mertwole/tetris/fpga_to_pcie/schematic.pdf

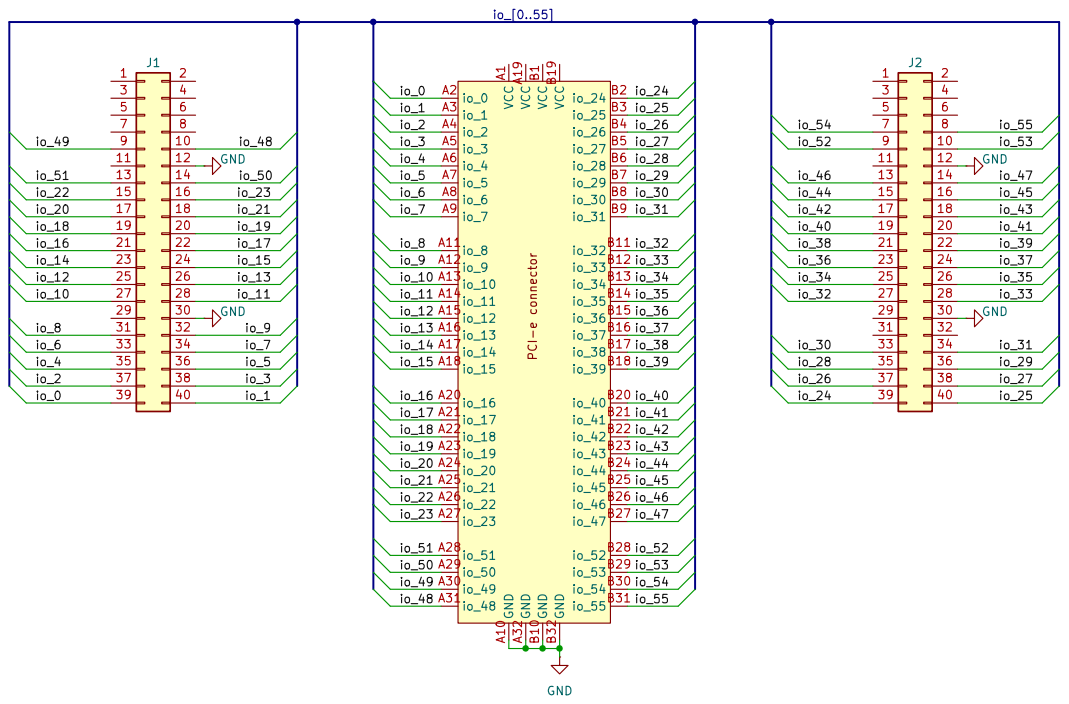
[picture p1: page 1]
