mertwole/tetris/module_tester/schematic.pdf

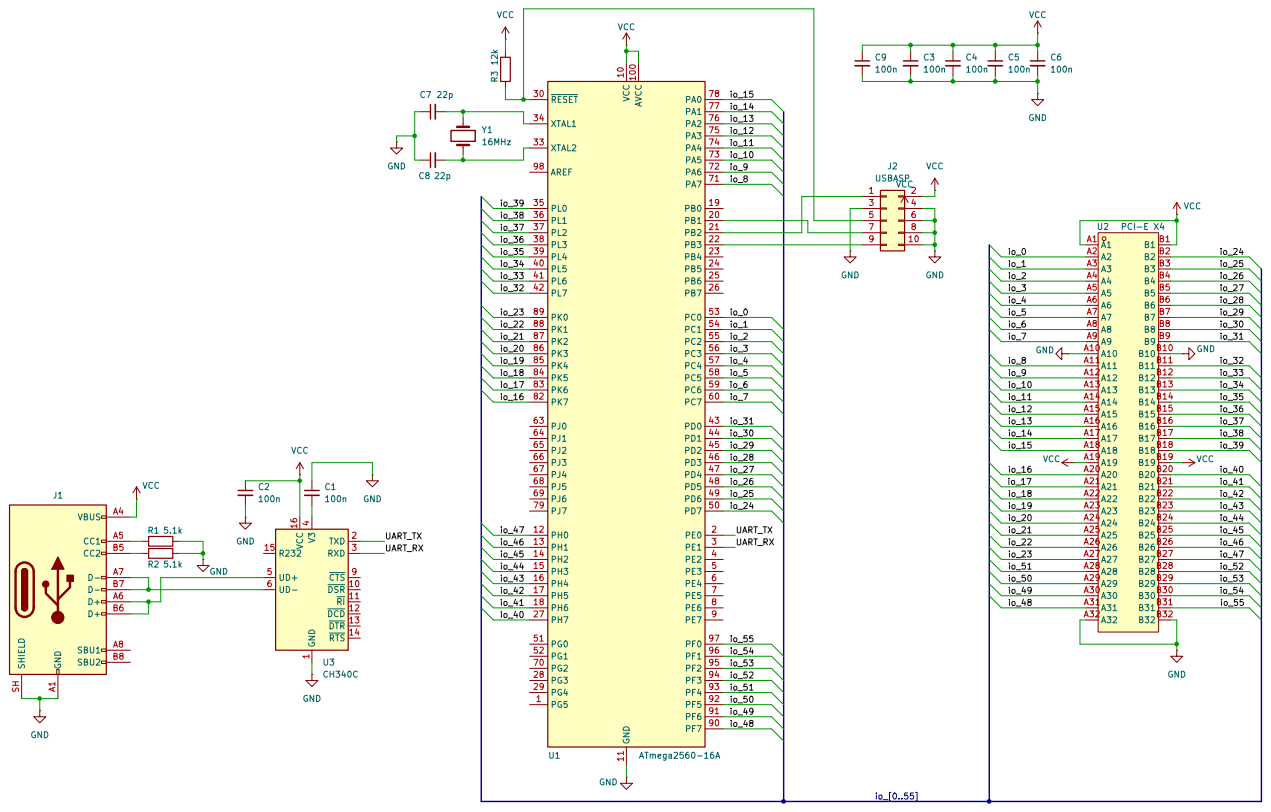
[picture p2: page 1]
