mertwole/tetris/fpga_to_pcie/fpga_to_pcie.kicad_pcb

## KiCad design fpga_to_pcie/fpga_to_pcie.kicad_pcb (2026-09-05)

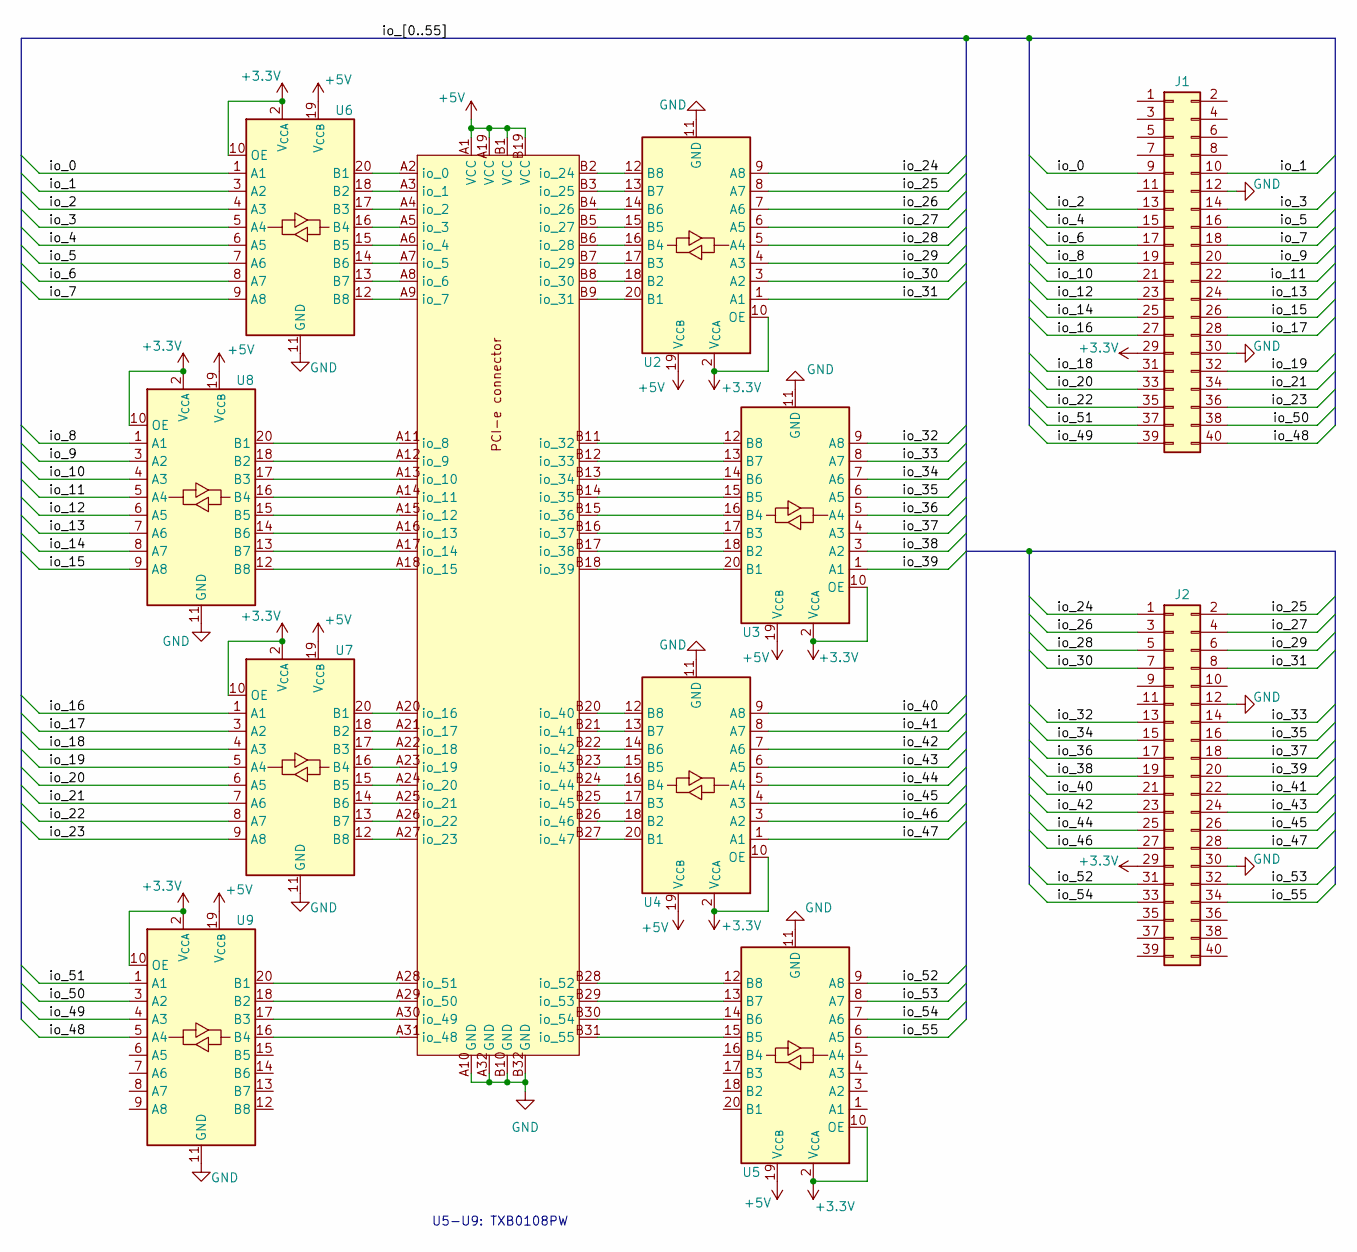
[picture p3: schematic fpga_to_pcie.kicad_sch]

Parts:
J1, J2: Conn_02x20_Odd_Even; IDC-Header_2x20_P2.54mm_Vertical
U1: BUS_PCIexpress_x4
U2, U3, U4, U5, U6, U7, U8, U9: TXB0108PW; TSSOP-20_4.4x6.5mm_P0.65mm

Connections:
+3.3V: J1.29, J2.29, U2.2 (V_{CCA}), U2.10 (OE), U3.2 (V_{CCA}), U3.10 (OE), U4.2 (V_{CCA}), U4.10 (OE), U5.2 (V_{CCA}), U5.10 (OE), U6.2 (V_{CCA}), U6.10 (OE), U7.2 (V_{CCA}), U7.10 (OE), U8.2 (V_{CCA}), U8.10 (OE), U9.2 (V_{CCA}), U9.10 (OE)
+5V: U1.A1 (VCC), U1.A19 (VCC), U1.B1 (VCC), U1.B19 (VCC), U2.19 (V_{CCB}), U3.19 (V_{CCB}), U4.19 (V_{CCB}), U5.19 (V_{CCB}), U6.19 (V_{CCB}), U7.19 (V_{CCB}), U8.19 (V_{CCB}), U9.19 (V_{CCB})
/io_0: J1.9, U6.1 (A1)
/io_1: J1.10, U6.3 (A2)
/io_2: J1.13, U6.4 (A3)
/io_3: J1.14, U6.5 (A4)
/io_4: J1.15, U6.6 (A5)
/io_5: J1.16, U6.7 (A6)
/io_6: J1.17, U6.8 (A7)
/io_7: J1.18, U6.9 (A8)
/io_8: J1.19, U8.1 (A1)
/io_9: J1.20, U8.3 (A2)
/io_10: J1.21, U8.4 (A3)
/io_11: J1.22, U8.5 (A4)
/io_12: J1.23, U8.6 (A5)
/io_13: J1.24, U8.7 (A6)
/io_14: J1.25, U8.8 (A7)
/io_15: J1.26, U8.9 (A8)
/io_16: J1.27, U7.1 (A1)
/io_17: J1.28, U7.3 (A2)
/io_18: J1.31, U7.4 (A3)
/io_19: J1.32, U7.5 (A4)
/io_20: J1.33, U7.6 (A5)
/io_21: J1.34, U7.7 (A6)
/io_22: J1.35, U7.8 (A7)
/io_23: J1.36, U7.9 (A8)
/io_24: J2.1, U2.9 (A8)
/io_25: J2.2, U2.8 (A7)
/io_26: J2.3, U2.7 (A6)
/io_27: J2.4, U2.6 (A5)
/io_28: J2.5, U2.5 (A4)
/io_29: J2.6, U2.4 (A3)
/io_30: J2.7, U2.3 (A2)
/io_31: J2.8, U2.1 (A1)
/io_32: J2.13, U3.9 (A8)
/io_33: J2.14, U3.8 (A7)
/io_34: J2.15, U3.7 (A6)
/io_35: J2.16, U3.6 (A5)
/io_36: J2.17, U3.5 (A4)
/io_37: J2.18, U3.4 (A3)
/io_38: J2.19, U3.3 (A2)
/io_39: J2.20, U3.1 (A1)
/io_40: J2.21, U4.9 (A8)
/io_41: J2.22, U4.8 (A7)
/io_42: J2.23, U4.7 (A6)
/io_43: J2.24, U4.6 (A5)
/io_44: J2.25, U4.5 (A4)
/io_45: J2.26, U4.4 (A3)
/io_46: J2.27, U4.3 (A2)
/io_47: J2.28, U4.1 (A1)
/io_48: J1.40, U9.5 (A4)
/io_49: J1.39, U9.4 (A3)
/io_50: J1.38, U9.3 (A2)
/io_51: J1.37, U9.1 (A1)
/io_52: J2.31, U5.9 (A8)
/io_53: J2.32, U5.8 (A7)
/io_54: J2.33, U5.7 (A6)
/io_55: J2.34, U5.6 (A5)
GND: J1.12, J1.30, J2.12, J2.30, U1.A10 (GND), U1.A32 (GND), U1.B10 (GND), U1.B32 (GND), U2.11 (GND), U3.11 (GND), U4.11 (GND), U5.11 (GND), U6.11 (GND), U7.11 (GND), U8.11 (GND), U9.11 (GND)
unnamed: U1.A2 (io_0), U6.20 (B1)
unnamed: U1.A3 (io_1), U6.18 (B2)
unnamed: U1.A4 (io_2), U6.17 (B3)
unnamed: U1.A5 (io_3), U6.16 (B4)
unnamed: U1.A6 (io_4), U6.15 (B5)
unnamed: U1.A7 (io_5), U6.14 (B6)
unnamed: U1.A8 (io_6), U6.13 (B7)
unnamed: U1.A9 (io_7), U6.12 (B8)
unnamed: U1.A11 (io_8), U8.20 (B1)
unnamed: U1.A12 (io_9), U8.18 (B2)
unnamed: U1.A13 (io_10), U8.17 (B3)
unnamed: U1.A14 (io_11), U8.16 (B4)
unnamed: U1.A15 (io_12), U8.15 (B5)
unnamed: U1.A16 (io_13), U8.14 (B6)
unnamed: U1.A17 (io_14), U8.13 (B7)
unnamed: U1.A18 (io_15), U8.12 (B8)
unnamed: U1.A20 (io_16), U7.20 (B1)
unnamed: U1.A21 (io_17), U7.18 (B2)
unnamed: U1.A22 (io_18), U7.17 (B3)
unnamed: U1.A23 (io_19), U7.16 (B4)
unnamed: U1.A24 (io_20), U7.15 (B5)
unnamed: U1.A25 (io_21), U7.14 (B6)
unnamed: U1.A26 (io_22), U7.13 (B7)
unnamed: U1.A27 (io_23), U7.12 (B8)
unnamed: U1.B2 (io_24), U2.12 (B8)
unnamed: U1.B3 (io_25), U2.13 (B7)
unnamed: U1.B4 (io_26), U2.14 (B6)
unnamed: U1.B5 (io_27), U2.15 (B5)
unnamed: U1.B6 (io_28), U2.16 (B4)
unnamed: U1.B7 (io_29), U2.17 (B3)
unnamed: U1.B8 (io_30), U2.18 (B2)
unnamed: U1.B9 (io_31), U2.20 (B1)
unnamed: U1.B11 (io_32), U3.12 (B8)
unnamed: U1.B12 (io_33), U3.13 (B7)
unnamed: U1.B13 (io_34), U3.14 (B6)
unnamed: U1.B14 (io_35), U3.15 (B5)
unnamed: U1.B15 (io_36), U3.16 (B4)
unnamed: U1.B16 (io_37), U3.17 (B3)
unnamed: U1.B17 (io_38), U3.18 (B2)
unnamed: U1.B18 (io_39), U3.20 (B1)
unnamed: U1.B20 (io_40), U4.12 (B8)
unnamed: U1.B21 (io_41), U4.13 (B7)
unnamed: U1.B22 (io_42), U4.14 (B6)
unnamed: U1.B23 (io_43), U4.15 (B5)
unnamed: U1.B24 (io_44), U4.16 (B4)
unnamed: U1.B25 (io_45), U4.17 (B3)
unnamed: U1.B26 (io_46), U4.18 (B2)
unnamed: U1.B27 (io_47), U4.20 (B1)
unnamed: U1.A31 (io_48), U9.16 (B4)
unnamed: U1.A30 (io_49), U9.17 (B3)
unnamed: U1.A29 (io_50), U9.18 (B2)
unnamed: U1.A28 (io_51), U9.20 (B1)
unnamed: U1.B28 (io_52), U5.12 (B8)
unnamed: U1.B29 (io_53), U5.13 (B7)
unnamed: U1.B30 (io_54), U5.14 (B6)
unnamed: U1.B31 (io_55), U5.15 (B5)

Notes on the sheet:
U5-U9: TXB0108PW

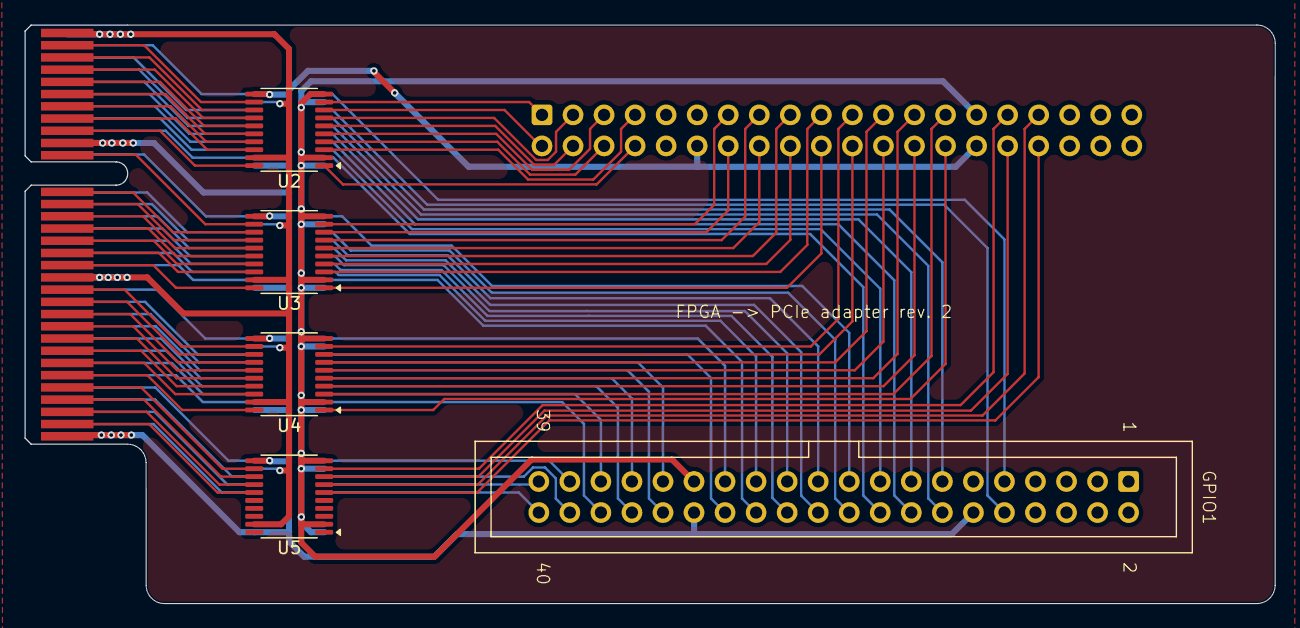
[picture p4: board fpga_to_pcie.kicad_pcb from above]

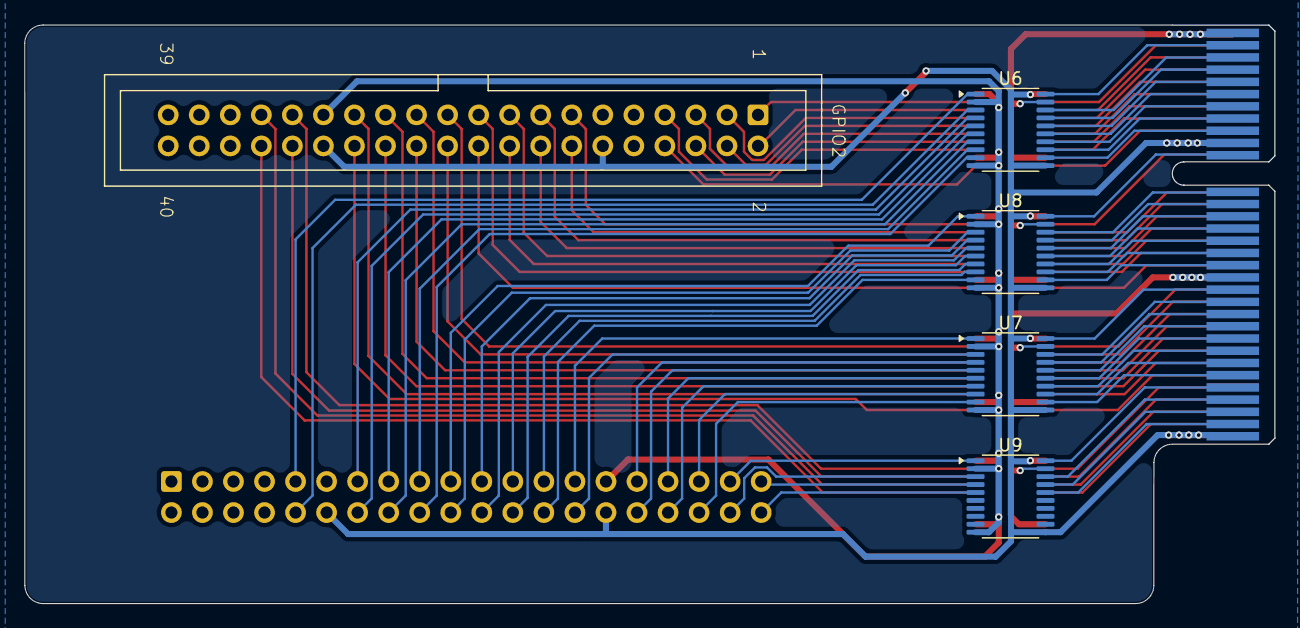
[picture p5: board fpga_to_pcie.kicad_pcb from below]

Board: 2 copper layers, 102.3 x 47.3 mm, 11 parts (5 on the bottom side), 115 nets.
