mertwole/tetris/module_tester/module_tester.kicad_pcb

## KiCad design module_tester/module_tester.kicad_pcb (2026-08-26)

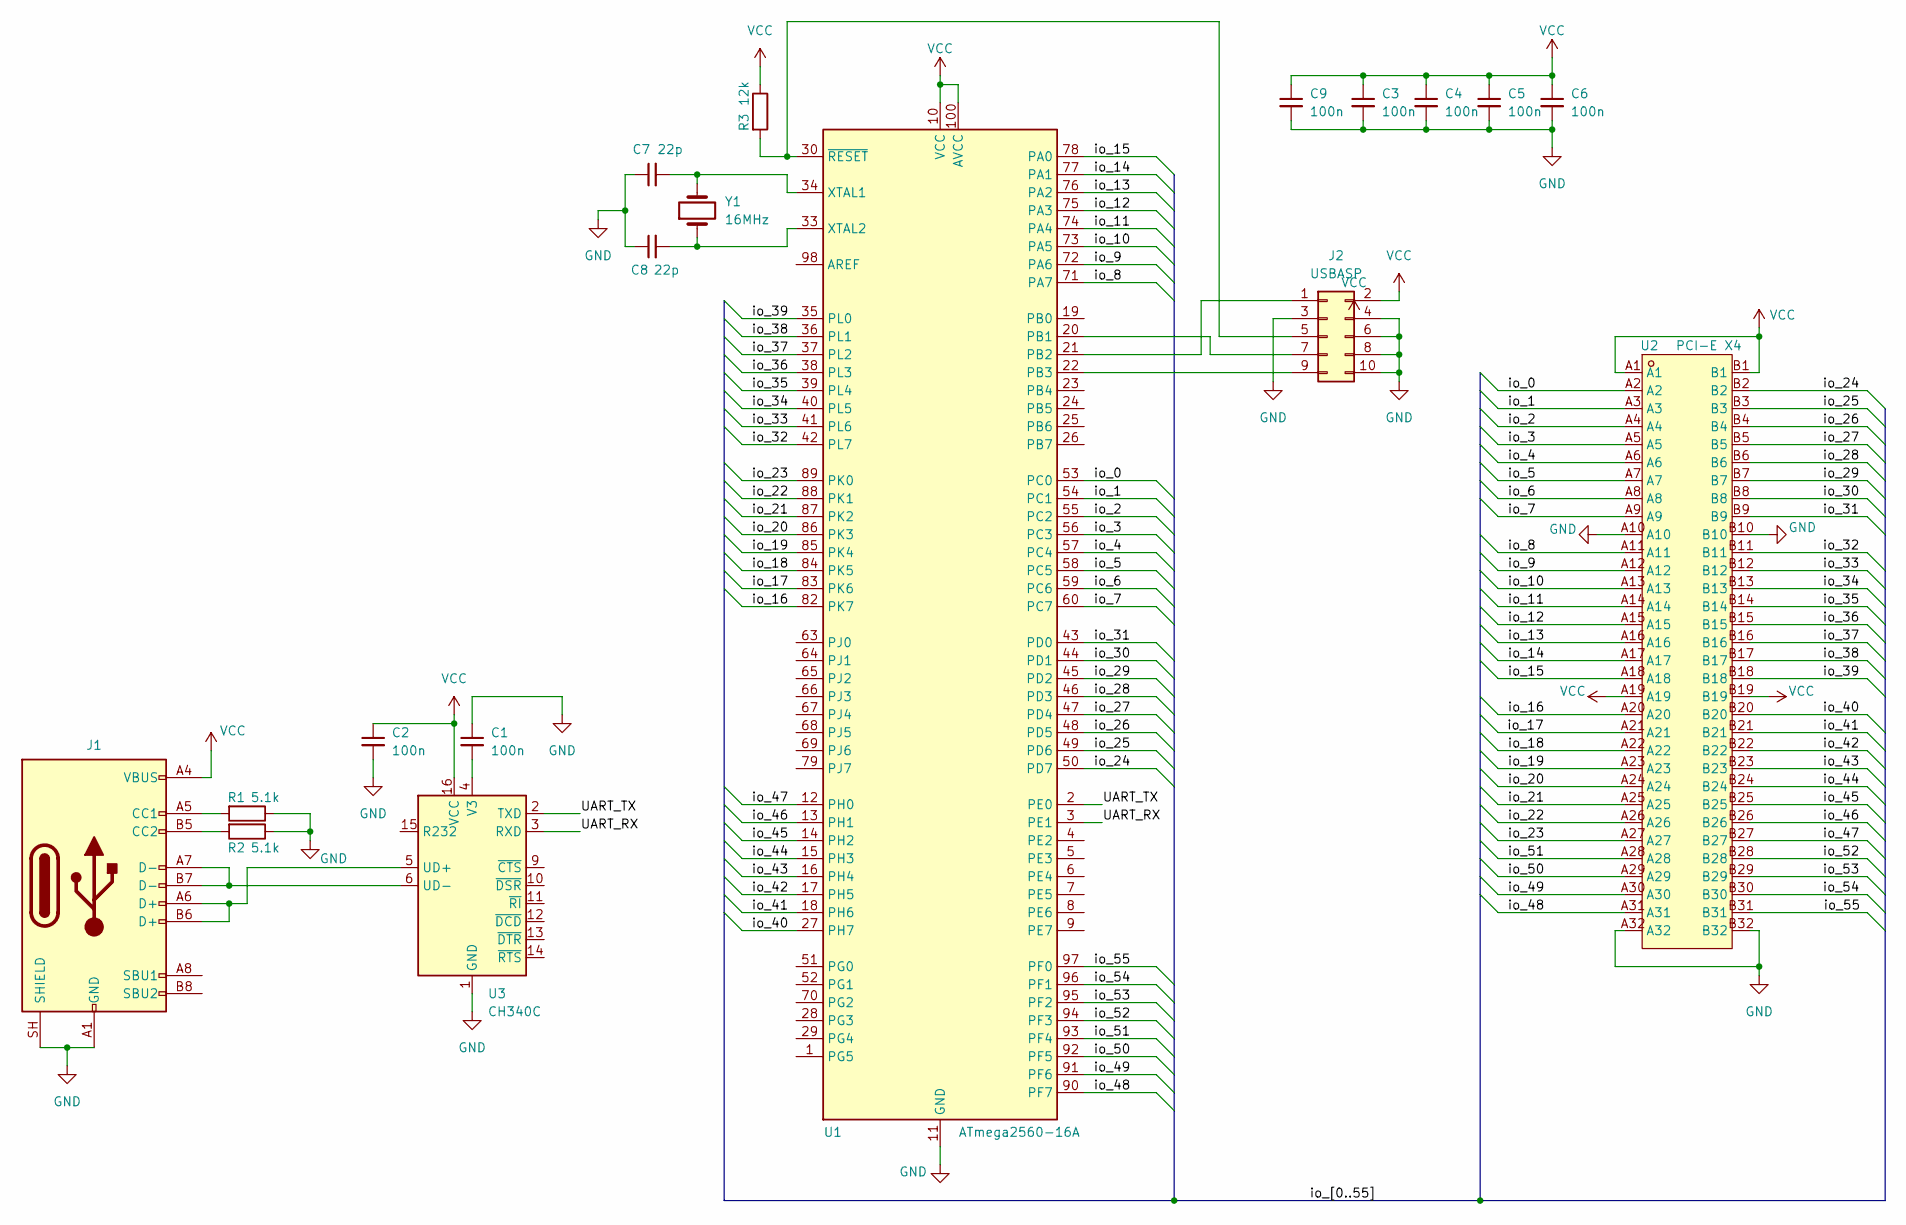
[picture p6: schematic module_tester.kicad_sch]

Parts:
C1, C2, C3, C4, C5, C6, C9: 100n; C_0603_1608Metric
C7, C8: 22p; C_0603_1608Metric
J1: USB_C_Receptacle_USB2.0_16P; USB_C_Receptacle_G-Switch_GT-USB-7010ASV
J2: USBASP; IDC-Header_2x05_P2.54mm_Vertical
R1, R2: 5.1k; R_1206_3216Metric
R3: 12k; R_1206_3216Metric
U1: ATmega2560-16A; TQFP-100_14x14mm_P0.5mm
U2: PCI-E X4; PCI-E X4 Socket; MPN 2EG03227-D2D-DF; LCSC Part C2832353
U3: CH340C; SOIC-16_3.9x9.9mm_P1.27mm
Y1: 16MHz; Crystal_SMD_HC49-SD_HandSoldering

Connections:
/UART_RX: U1.3 (PE1), U3.3 (RXD)
/UART_TX: U1.2 (PE0), U3.2 (TXD)
/io_0: U1.53 (PC0), U2.A2
/io_1: U1.54 (PC1), U2.A3
/io_2: U1.55 (PC2), U2.A4
/io_3: U1.56 (PC3), U2.A5
/io_4: U1.57 (PC4), U2.A6
/io_5: U1.58 (PC5), U2.A7
/io_6: U1.59 (PC6), U2.A8
/io_7: U1.60 (PC7), U2.A9
/io_8: U1.71 (PA7), U2.A11
/io_9: U1.72 (PA6), U2.A12
/io_10: U1.73 (PA5), U2.A13
/io_11: U1.74 (PA4), U2.A14
/io_12: U1.75 (PA3), U2.A15
/io_13: U1.76 (PA2), U2.A16
/io_14: U1.77 (PA1), U2.A17
/io_15: U1.78 (PA0), U2.A18
/io_16: U1.82 (PK7), U2.A20
/io_17: U1.83 (PK6), U2.A21
/io_18: U1.84 (PK5), U2.A22
/io_19: U1.85 (PK4), U2.A23
/io_20: U1.86 (PK3), U2.A24
/io_21: U1.87 (PK2), U2.A25
/io_22: U1.88 (PK1), U2.A26
/io_23: U1.89 (PK0), U2.A27
/io_24: U1.50 (PD7), U2.B2
/io_25: U1.49 (PD6), U2.B3
/io_26: U1.48 (PD5), U2.B4
/io_27: U1.47 (PD4), U2.B5
/io_28: U1.46 (PD3), U2.B6
/io_29: U1.45 (PD2), U2.B7
/io_30: U1.44 (PD1), U2.B8
/io_31: U1.43 (PD0), U2.B9
/io_32: U1.42 (PL7), U2.B11
/io_33: U1.41 (PL6), U2.B12
/io_34: U1.40 (PL5), U2.B13
/io_35: U1.39 (PL4), U2.B14
/io_36: U1.38 (PL3), U2.B15
/io_37: U1.37 (PL2), U2.B16
/io_38: U1.36 (PL1), U2.B17
/io_39: U1.35 (PL0), U2.B18
/io_40: U1.27 (PH7), U2.B20
/io_41: U1.18 (PH6), U2.B21
/io_42: U1.17 (PH5), U2.B22
/io_43: U1.16 (PH4), U2.B23
/io_44: U1.15 (PH3), U2.B24
/io_45: U1.14 (PH2), U2.B25
/io_46: U1.13 (PH1), U2.B26
/io_47: U1.12 (PH0), U2.B27
/io_48: U1.90 (PF7), U2.A31
/io_49: U1.91 (PF6), U2.A30
/io_50: U1.92 (PF5), U2.A29
/io_51: U1.93 (PF4), U2.A28
/io_52: U1.94 (PF3), U2.B28
/io_53: U1.95 (PF2), U2.B29
/io_54: U1.96 (PF1), U2.B30
/io_55: U1.97 (PF0), U2.B31
GND: C1.1, C2.2, C3.2, C4.2, C5.2, C6.2, C7.1, C8.1, C9.2, J1.A1 (GND), J1.A12 (GND), J1.B1 (GND), J1.B12 (GND), J1.SH (SHIELD), J2.3, J2.4, J2.6, J2.8, J2.10, R1.1, R2.1, U1.11 (GND), U1.32 (GND), U1.62 (GND), U1.81 (GND), U1.99 (GND), U2.A10, U2.A32, U2.B10, U2.B32, U3.1 (GND)
unnamed: J1.A5 (CC1), R1.2
unnamed: J1.B5 (CC2), R2.2
unnamed: J2.1, U1.21 (PB2)
unnamed: J2.5, R3.2, U1.30 (~RESET)
unnamed: J2.7, U1.20 (PB1)
unnamed: J2.9, U1.22 (PB3)
unnamed: C7.2, U1.34 (XTAL1), Y1.2
unnamed: C8.2, U1.33 (XTAL2), Y1.1
unnamed: J1.A6 (D+), J1.B6 (D+), U3.5 (UD+)
unnamed: J1.A7 (D-), J1.B7 (D-), U3.6 (UD-)
unnamed: C1.2, U3.4 (V3)
VCC: C2.1, C3.1, C4.1, C5.1, C6.1, C9.1, J1.A4 (VBUS), J1.A9 (VBUS), J1.B4 (VBUS), J1.B9 (VBUS), J2.2, R3.1, U1.10 (VCC), U1.31 (VCC), U1.61 (VCC), U1.80 (VCC), U1.100 (AVCC), U2.A1, U2.A19, U2.B1, U2.B19, U3.16 (VCC)

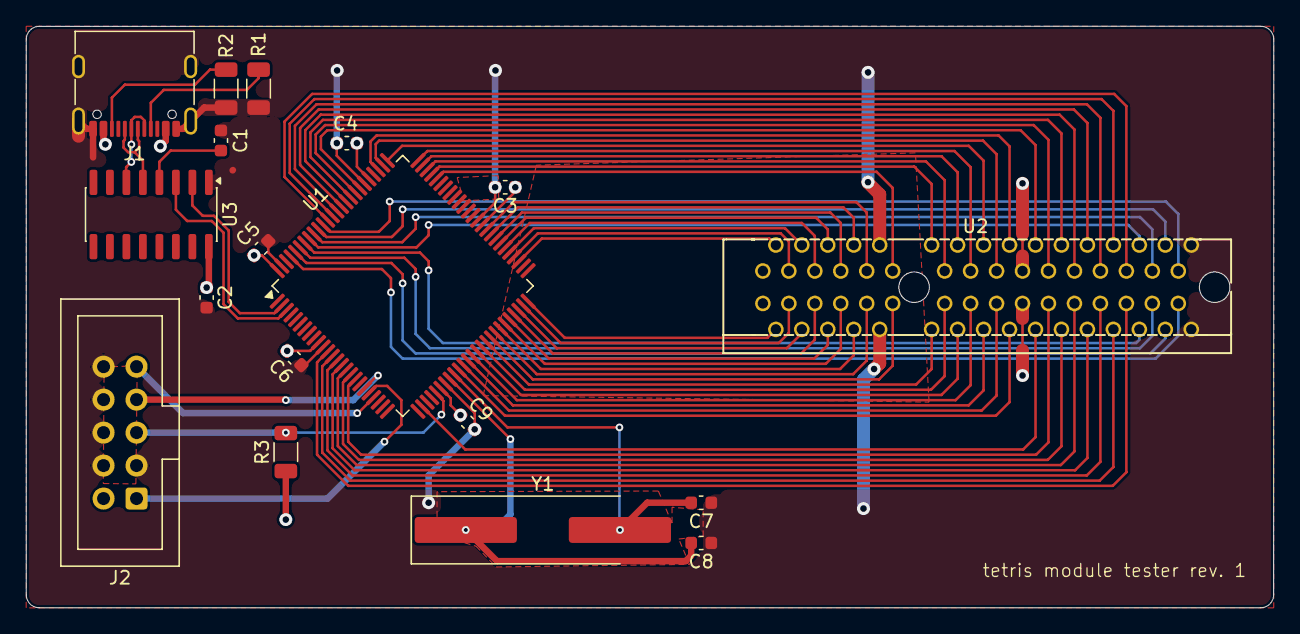
[picture p7: board module_tester.kicad_pcb from above]

Board: 2 copper layers, 96.1 x 44.8 mm, 18 parts (0 on the bottom side), 71 nets.
