mertwole/tetris/(commit log)

2026-08-04 feat: `burn` module (#14)
    [burn.v]
2026-08-10 feat: IO board schematic (#27)
    [io_board_1.0.kicad_sch]
2026-08-11 refactor: count burned lines in BCD (#30)
    [main.v, scores.v]
2026-08-11 feat: wire the `image_encoder` and `field` together (#31)
2026-08-12 feat: connect `burn` module (#34)
    [burn.v, main.v]
2026-08-13 feat: display the current piece in `game_loop` (#36)
2026-08-22 feat: module tester schematic (#45)
    [module_tester.kicad_pcb, module_tester.kicad_sch]
2026-08-23 feat: module tester PCB design (#46)
    [module_tester.kicad_pcb, module_tester.kicad_sch]
2026-08-26 feat: FPGA to PCIe breakout board (#47)
    [fpga_to_pcie.kicad_pcb, fpga_to_pcie.kicad_sch]
2026-08-26 refactor: improve length matching on USB in module tester (#48)
    [module_tester.kicad_pcb]
2026-09-05 feat: FPGA to PCI-E adapter schematic and PCB (#49)
    [fpga_to_pcie.kicad_pcb, fpga_to_pcie.kicad_sch]
2026-11-04 feat: play burn animation (#52)
    [burn.v, game_loop.v, main.v]
